Arshgill01/GridQ/docs/GridQ-Project-Description.pdf

HACK-O-OCTO 4.0 · PS08 · ENERGY FOR THE NEXT BILLION
An offline energy brain for a campus microgrid with a clinic on it. It forecasts,

## optimises and explains every 15 minutes on an Arduino UNO Q, and it keeps

the clinic powered when its own software fails.

T H E P R O B L E M

Campuses and health centres on weak grids run solar, a battery and a diesel

genset on fixed rules: charge at noon, discharge in the evening, start the

genset below 20%. Rules can't see tomorrow's demand, can't tell that an outage at 19:00 costs more than one at 03:00, and can't weigh ₹27/kWh

diesel against cutting a hostel. When the controller crashes, nobody is in

charge.

W H A T G R I D Q D O E S

GridQ replaces the rules with an optimiserthat prices every choice in

rupees: grid, battery, diesel, deferring an EV or pump, trimming a feeder. It

plans 24 hours ahead against the grid failing, applies the next 15 minutes,

and explains each decision. A microcontrollerthat doesn't trust the

optimiser holds the safety layer.

H O W I T W O R K S

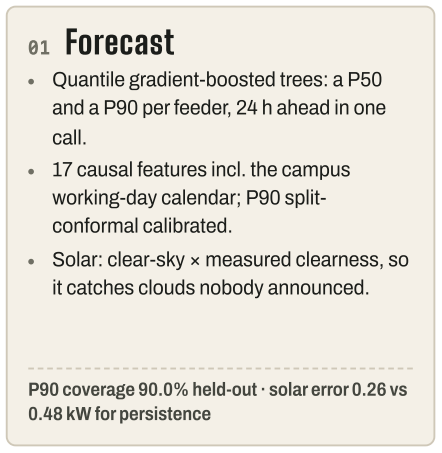
[picture p9: figure]
01 Forecast; Quantile gradient-boosted trees: a P50; and a P90 per feeder, 24 h ahead in one; call.; 17 causal features incl. the campus; working-day calendar; P90 split-; conformal calibrated.; it catches clouds nobody announced.; 0.48 kW for persistence

Solar: clear-sky × measured clearness, so

P90 coverage 90.0% held-out · solar error 0.26 vs

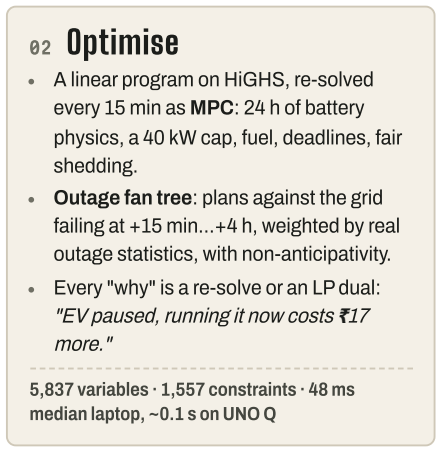
[picture p10: figure]
02 Optimise; A linear program on HiGHS, re-solved; every 15 min as MPC: 24 h of battery; shedding.; Outage fan tree: plans against the grid; outage statistics, with non-anticipativity.; Every "why" is a re-solve or an LPdual:; "EV paused, running it now costs ₹17; more."; median laptop, ~0.1 s on UNOQ

physics, a 40 kW cap, fuel, deadlines, fair

failing at +15 min…+4 h, weighted by real

5,837 variables · 1,557 constraints · 48 ms

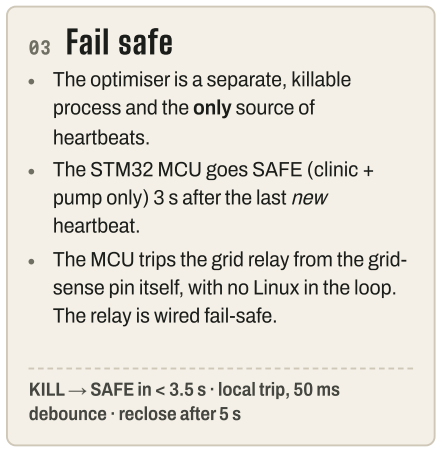
[picture p11: figure]
03 Fail safe; The optimiser is a separate, killable; process and the only source of; heartbeats.; The STM32 MCU goes SAFE (clinic +; pump only) 3 s after the last new; heartbeat.; The relay is wired fail-safe.; debounce · reclose after 5 s

The MCU trips the grid relay from the grid-

sense pin itself, with no Linux in the loop.

KILL → SAFE in < 3.5 s · local trip, 50 ms

R E S U L T S O N H E L D - O U T R E A L D A T A

DEC 2017 · 100 DAYS | TOTAL COST | UNSERVED | CLINIC | FAIRNESS
B0 · inverter default | ₹7,83,106 | 1,489 kWh | 100% | 0.38
B1 · tuned time-of-day rules | ₹8,05,486 | 1,335 kWh | 100% | 0.44
GridQ | ₹7,67,968 | 317 kWh | 100% | 1.00
Oracle · perfect foresight | ₹7,48,038 | 17 kWh | 100% | 1.00

Real I-BLEND campus demand (IIIT-Delhi) and NASA POWER solar on days the forecaster never

saw, each with 5 random outage patterns. Tuned on days 1–10,reported on 11–30. Total cost =

energy + diesel + demand charge + battery wear + value of lost load. Fairness = Jain index.

43%

of the achievable saving

captured vs the stronger

baseline; 65% vs B1 (the spec's

measure)

−79%

unserved energy vs B0, shared

fairly instead of always cutting

one hostel

93%

captured in the summer stress

block, when the 40 kW grid cap

binds

67.5%

captured by the outage fan tree

on tune days; the spec's fixed

clinic reserve scored −38.6%

A R C H I T E C T U R E · W H A T E V E R C A N C R A S H I S N O T I N C H A R G E O F S A F E T Y

## ESP32 clinic node

LCD: grid, clinic secure

hours, the LP's

reasoning · servo

battery gauge ·

ultrasonic EV sensor

ARDUINO UNO Q · LINUX (QRB2210)

### gridq-io

Always on: plant twin,

dashboard, event log,

sole owner of the MCU

link, respawns the brain

### gridq-brain

Killable: forecast → LP

→ explain, re-plans

every step; heartbeat

every 500 ms

## STM32 MCU

Authority for outputs: 3 s heartbeat watchdog →

SAFE · local grid trip

### Field

D3 grid sense · D2

relay (fail-safe) · LED

matrix · buzzer

B R E A K I T , L I V E

Pull the D3 jumper

The MCU islands the site by itself: relay

clicks, buzzer sounds. The LPre-plans

on battery + diesel and trims by price,

with the clinic last.

Press KILL

SIGKILL the optimiser. Heartbeats stop,

the MCU goes SAFE in under 3.5 s, the

brain respawns and NORMAL returns

on its own.

Cloud · EV fleet

Solar ×0.3 unannounced, or a hand

over the ultrasonic sensor adds 30 kWh

due by 06:00. The plan adapts on the

next step.

Battery fault

Capacity and power halve. The plan,

the clinic's secure hours and the servo

gauge all respond at once.

R E A L V S S I M U L A T E D

REAL | Forecaster, LP/MPC brain, explanations, MCU safety supervisor, relay, LED matrix, buzzer, ESP32 clinic node, demand and solar data.
SIM | The power plant (30 kWp solar, 50 kWh battery, 24 kW genset, feeders). Clinic demand is modelled and labelled.

W H Y I T M A T T E R S

Runs fully offline on a credit-card-sized board, with no cloud and no deep

nets or LLMs. Every decision has a rupee explanation an operator can

check, and every number here is computed by the repo. Swap the plant twin

for real meter readings and the same LPand safety logic run a real site.

github.com/Arshgill01/GridQ · code, benchmark, hardware photos, design decisions | Arduino UNO Q (QRB2210 + STM32U585) · ESP32 · Python · HiGHS · scikit-learn · FastAPI

⇄Wi-Fi

1 Hz

⇄Bridge

RPC

→pins
