Arshgill01/GridQ/docs/img/live-dark.png

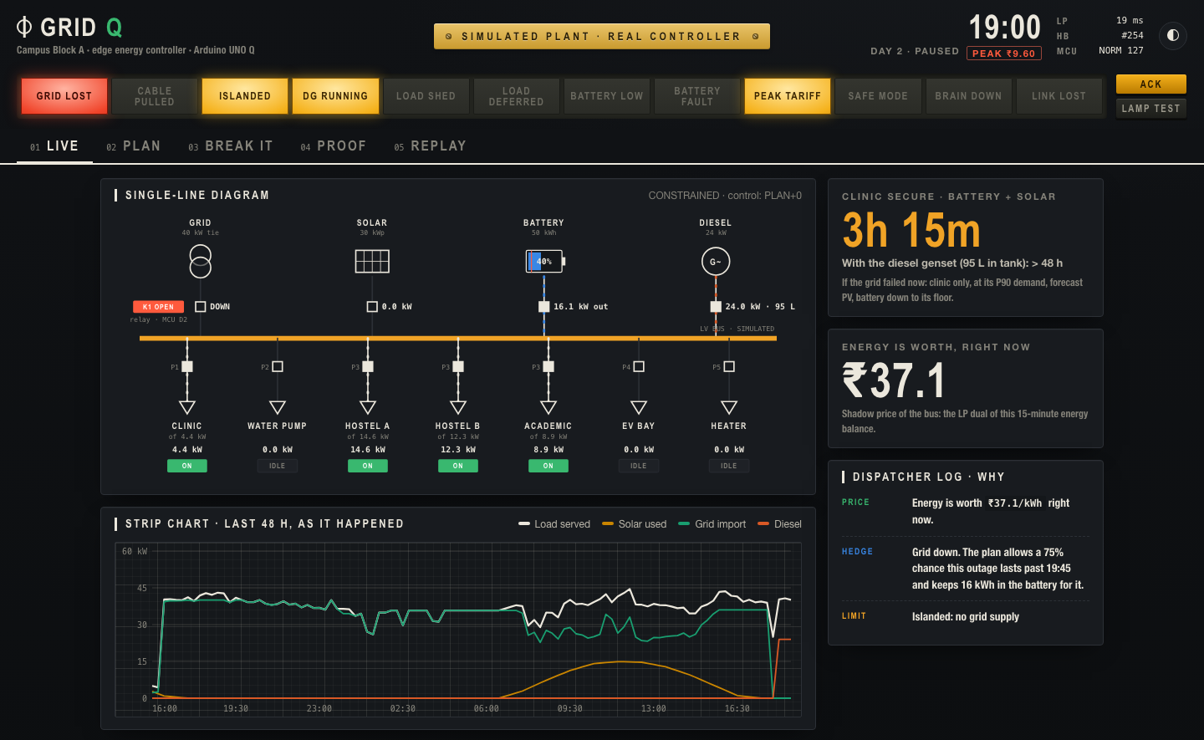
docs/img/live-dark.png
