Arshgill01/GridQ/docs/img/proof-tune.png

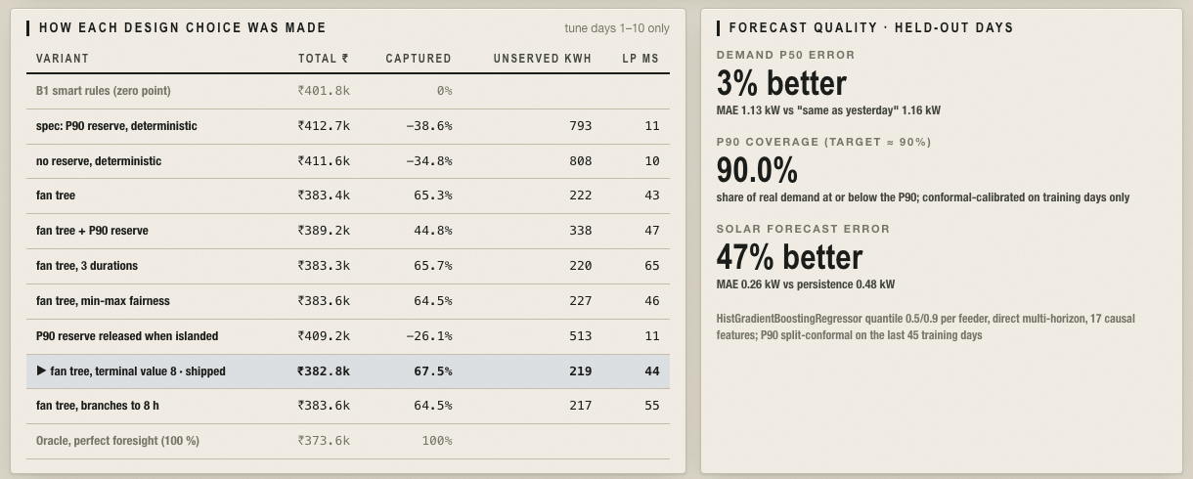
docs/img/proof-tune.png
