Arshgill01/GridQ/(commit log)

2026-10-23 Twin, B0/B1/SAFE, sparse HiGHS LP with outage fan tree, MPC + Oracle, metrics, run_days
    [hardware.yaml]
2026-10-23 Tests: energy balance, determinism, metrics, LP; NASA POWER fetcher
2026-10-23 Quantile forecaster (direct multi-horizon + conformal P90), calendar view, ESP32 firmware, DECISIONS.md
2026-10-23 Fan tree also models ongoing-outage restoration; deploy tooling; hardware test script
2026-10-23 Real data: I-BLEND prep (877 good days, Dec-2017 held out), NASA POWER, residual quantile GBM (beats naive, P90 89.7%)
    [demand_15min.csv, solar_hourly.csv]
2026-10-23 Rolling-origin folds (winter = spec, summer), causal scaling, per-fold forecasters, Oracle-vs-GridQ exception count
    [demand_15min.csv]
2026-10-23 Dashboard charts: validated palettes, no dual axis, crosshair tooltips; pin OpenMP threads (50x faster GBM inference)
2026-10-23 Diesel daily refill (plant fix), reserve release option, tuning harness results (fan tree +65% captured on tune days)
    [params.yaml, tune.py]
2026-10-23 Freeze controller config from tune days: fan tree, no fixed reserve, terminal value 8
    [params.yaml]
2026-10-23 Proof: fold switch with per-fold forecast + provenance
2026-10-23 Survival time split: battery+solar vs with diesel (visible change in demo); bad-JSON 400
2026-10-23 Deployed to UNO Q: real Bridge verified, SAFE on brain kill verified, 65 ms solves on board; pin numpy in app
    [hardware.yaml]
2026-10-23 ESP32 firmware compiles (rename BMP280 calib vars clashing with Xtensa T1..T3); vendored fonts
2026-10-23 MCU: open-drain relay drive so a 3.3 V UNO Q can release a 5 V active-LOW relay module (PB3 is 5 V tolerant; still fail-safe)
    [hardware.yaml]
2026-10-23 ESP32: reject sub-2 cm ultrasonic echoes (noise), gentler Wi-Fi retry, 1 Hz distance debug print
    [clinic_node.ino]
2026-10-23 ESP32: log IP/HTTP status; noise echoes neither count nor reset the EV streak
    [clinic_node.ino]
2026-10-23 ESP32: auto-discover the UNO Q (configured host, then mDNS uno-q.local, then /24 sweep) so a new hotspot IP doesn't break the clinic node
    [clinic_node.ino]
2026-10-23 ESP32: disable modem sleep, rejoin Wi-Fi when connected but GridQ silent
2026-10-23 README: simpler flowchart syntax for GitHub's renderer
2026-10-23 README: pre-rendered light/dark architecture and fan-tree diagrams
2026-10-23 ESP32: wait for a booting GridQ instead of dropping Wi-Fi; non-blind discovery; clearer LED and boot LCD
2026-10-23 io: tag plans with the session so a solve in flight during RESET can't block new plans; README/RUNBOOK LED legend
2026-10-23 ESP32: EV trigger needs ~1 s of steady 3-12 cm readings, so wiring noise can't inject a fleet
    [clinic_node.ino]
2026-10-23 ESP32: servo gauge self-test sweep at boot, slew cap 60 -> 180 deg/s
